ultimachine/Drude/Panels/ProjectOutputs/readme.txt

Readme File for Printed Circuit Board 'Drude_Panel_0-1a'

Board Specification
Part Number            DRUDE
Revision               01a
Board size             49.813mm x 73.00mm
Panel size             151.978mm x 85.90mm
Board Thickness        1.54mm (0.061")
Board type             Rigid
Number of layers       4
P.C.B material         FR4 / TG170
Finished Copper        1 oz
Finish                 ENIG (Gold) (Lead free) (RoHS)
Mask type              LPI 
Mask color             GREEN
Silk screen color      WHITE
Silk screen Sides      BOTH
Min trace width        4mil
Min clearance          4mil
Min Hole Diameter >=   8mil
Gold Edge Connectors   No
Internal slots/routes  
Blind Vias             No
Buried Vias            No
No of Boards/Panel     3
Routing                Routing + V-Score
Maximum Panel Size     250 X 280mm

Special Requirements
1. Fabricate PCB in accordiance with IPC-A-600 CLASS 2 (LATEST REVISION)
2. The PCB must be lead free assembly process compatible.
  Must handle minimum 6 cycles - 260C for 10 seconds.
3. Please ship PCB panelized as in gerber files.
  
UL LOGO + ID and ROHS logo to be placed on solder side (bottom silk screen) by board fab.

Critical Tolerances: 
1. GTL,GBL Differential Trace
	4mil, 8mil space  = 100ohm diff
	5mil, 8mil space = 90ohm diff
	Z = +/- 10%

Layer Description
(Note: Inner layers are counted from the top downwards)
Top Solder Mask               Drude_Panel_0.1a.GTS
Top Copper                    Drude_Panel_0.1a.GTL
Bottom Copper                 Drude_Panel_0.1a.GBL
Bottom Solder Mask            Drude_Panel_0.1a.GBS
Bottom Silk Screen            Drude_Panel_0.1a.GBO
Top Paste                     Drude_Panel_0.1a.GBP
NC Drill File                 Drude_Panel_0.1a.TXT
Outline			      		  Drude_Panel_0.1a.GM1
Fabrication Notes             Drude_Panel_0.1a.GM2
Panel Outline                 Drude_Panel_0.1a.GM30
V-Score                       Drude_Panel_0.1a.GM31
Panel Slots/Routing           Drude_Panel_0.1a.GM32

Contact Information
Address
Company        UltiMachine
Address        200 12th St. N.
City           South Pittsburg
State          TN
PostCode       37380
Country        USA
Email          info@ultimachine.com
Phone          423-228-0005

Purchasing contact : Lee Turner - lee@ultimachine.com
Technical contact  : Johnny Russell - johnny@ultimachine.com - 1-423-605-2598

Please quote quantities of:
21 pieces / 7 panels
102 pieces / 34 panels
504 pieces / 168 panels
