ultimachine/Drude/Drude/MessageListReport.html

Altium customize

# Message List

Date: | | 11/25/2015
Time: | | 12:50:40 PM
Elapsed Time: | | 00:00:00

Class | Document | Source | Message | Time | Date | No.
[Differential Pairs Routing Violation] | Drude02.PcbDoc | Advanced PCB | Differential Pairs Routing: Between Net HDMI_CK_P And Net HDMI_CK_N [Uncoupled Length = 106.7mil], [Maximum Uncoupled Length = 78.74mil] | 12:49:37 PM | 11/25/2015 | 1
[Differential Pairs Routing Violation] | Drude02.PcbDoc | Advanced PCB | Differential Pairs Routing: Between Net HDMI_D0_P And Net HDMI_D0_N [Uncoupled Length = 93.132mil], [Maximum Uncoupled Length = 78.74mil] | 12:49:37 PM | 11/25/2015 | 2
[Differential Pairs Routing Violation] | Drude02.PcbDoc | Advanced PCB | Differential Pairs Routing: Between Net HDMI_D1_P And Net HDMI_D1_N [Uncoupled Length = 82.128mil], [Maximum Uncoupled Length = 78.74mil] | 12:49:37 PM | 11/25/2015 | 3
[Differential Pairs Routing Violation] | Drude02.PcbDoc | Advanced PCB | Differential Pairs Routing: Between Net HDMI_D2_P And Net HDMI_D2_N [Uncoupled Length = 147.876mil], [Maximum Uncoupled Length = 78.74mil] | 12:49:37 PM | 11/25/2015 | 4
[Differential Pairs Routing Violation] | Drude02.PcbDoc | Advanced PCB | Differential Pairs Routing: Between Net HDMI_CON_CK_P And Net HDMI_CON_CK_N [Uncoupled Length = 102.772mil], [Maximum Uncoupled Length = 78.74mil] | 12:49:37 PM | 11/25/2015 | 5
[Differential Pairs Routing Violation] | Drude02.PcbDoc | Advanced PCB | Differential Pairs Routing: Between Net HDMI_CON_D0_P And Net HDMI_CON_D0_N [Uncoupled Length = 112.768mil], [Maximum Uncoupled Length = 78.74mil] | 12:49:37 PM | 11/25/2015 | 6
[Differential Pairs Routing Violation] | Drude02.PcbDoc | Advanced PCB | Differential Pairs Routing: Between Net HDMI_CON_D1_P And Net HDMI_CON_D1_N [Uncoupled Length = 112.823mil], [Maximum Uncoupled Length = 78.74mil] | 12:49:37 PM | 11/25/2015 | 7
[Differential Pairs Routing Violation] | Drude02.PcbDoc | Advanced PCB | Differential Pairs Routing: Between Net HDMI_CON_D2_P And Net HDMI_CON_D2_N [Uncoupled Length = 104.291mil], [Maximum Uncoupled Length = 78.74mil] | 12:49:37 PM | 11/25/2015 | 8
[Parallel Segment Constraint Violation] | Drude02.PcbDoc | Advanced PCB | Parallel Segment Constraint: (526.811mil > 500mil) Between Net UD_N And Net UD_P Gap < 42mil; Actual Parallel Span = 526.811mil | 12:49:37 PM | 11/25/2015 | 9
[Parallel Segment Constraint Violation] | Drude02.PcbDoc | Advanced PCB | Parallel Segment Constraint: (539.011mil > 500mil) Between Net LANE3_N And Net LANE3_P Gap < 42mil; Actual Parallel Span = 539.011mil | 12:49:37 PM | 11/25/2015 | 10
[Parallel Segment Constraint Violation] | Drude02.PcbDoc | Advanced PCB | Parallel Segment Constraint: (552.095mil > 500mil) Between Net LANE2_N And Net LANE2_P Gap < 42mil; Actual Parallel Span = 552.095mil | 12:49:37 PM | 11/25/2015 | 11
[Parallel Segment Constraint Violation] | Drude02.PcbDoc | Advanced PCB | Parallel Segment Constraint: (552.095mil > 500mil) Between Net LANE2_P And Net LANE2_N Gap < 42mil; Actual Parallel Span = 552.095mil | 12:49:37 PM | 11/25/2015 | 12
[Parallel Segment Constraint Violation] | Drude02.PcbDoc | Advanced PCB | Parallel Segment Constraint: (512.301mil > 500mil) Between Net LANE1_N And Net LANE1_P Gap < 42mil; Actual Parallel Span = 512.301mil | 12:49:37 PM | 11/25/2015 | 13
[Parallel Segment Constraint Violation] | Drude02.PcbDoc | Advanced PCB | Parallel Segment Constraint: (556.64mil > 500mil) Between Net LANE0_N And Net LANE0_P Gap < 42mil; Actual Parallel Span = 556.64mil | 12:49:37 PM | 11/25/2015 | 14
[Parallel Segment Constraint Violation] | Drude02.PcbDoc | Advanced PCB | Parallel Segment Constraint: (556.64mil > 500mil) Between Net LANE0_P And Net LANE0_N Gap < 42mil; Actual Parallel Span = 556.64mil | 12:49:37 PM | 11/25/2015 | 15
[Parallel Segment Constraint Violation] | Drude02.PcbDoc | Advanced PCB | Parallel Segment Constraint: (505.987mil > 500mil) Between Net DSI_CLK_N And Net DSI_CLK_P Gap < 42mil; Actual Parallel Span = 505.987mil | 12:49:37 PM | 11/25/2015 | 16
[Clearance Constraint Violation] | Drude02.PcbDoc | Advanced PCB | Clearance Constraint: (10mil < 12mil) Between Via (234mil,1432mil) from Top Layer to Bottom Layer And Via (224mil,1456mil) from Top Layer to Bottom Layer | 12:49:37 PM | 11/25/2015 | 17
[Short-Circuit Constraint Violation] | Drude02.PcbDoc | Advanced PCB | Short-Circuit Constraint: Between Pad H3-1(1577.945mil,98.197mil) on Top Layer And Arc (1637mil,173mil) on Top Layer Location : [X = 2967.945mil][Y = 598.197mil] | 12:49:37 PM | 11/25/2015 | 18
[Short-Circuit Constraint Violation] | Drude02.PcbDoc | Advanced PCB | Short-Circuit Constraint: Between Pad H1-1(1597.945mil,1887.197mil) on Top Layer And Arc (1657mil,1962mil) on Top Layer Location : [X = 2987.945mil][Y = 2387.197mil] | 12:49:37 PM | 11/25/2015 | 19
[Short-Circuit Constraint Violation] | Drude02.PcbDoc | Advanced PCB | Short-Circuit Constraint: Between Pad H2-1(124.945mil,2622.197mil) on Top Layer And Arc (184mil,2697mil) on Top Layer Location : [X = 1514.945mil][Y = 3122.197mil] | 12:49:37 PM | 11/25/2015 | 20
[Short-Circuit Constraint Violation] | Drude02.PcbDoc | Advanced PCB | Short-Circuit Constraint: Between Pad H4-1(102.945mil,91.197mil) on Top Layer And Arc (162mil,166mil) on Top Layer Location : [X = 1492.945mil][Y = 591.197mil] | 12:49:37 PM | 11/25/2015 | 21
[Acute Angle Constraint Violation] | Drude02.PcbDoc | Advanced PCB | Acute Angle Constraint: (56.051 < 60.000) Between Polygon Region (0 hole(s)) Top Layer And Region (0 hole(s)) Top Layer (Angle = 56.051) | 12:49:37 PM | 11/25/2015 | 22
[Acute Angle Constraint Violation] | Drude02.PcbDoc | Advanced PCB | Acute Angle Constraint: (48.943 < 60.000) Between Track (1517.337mil,2594.943mil)(1525.733mil,2595.315mil) on Top Layer And Pad D27-6(1525.733mil,2595.315mil) on Top Layer (Angle = 48.943) | 12:49:37 PM | 11/25/2015 | 23
[Acute Angle Constraint Violation] | Drude02.PcbDoc | Advanced PCB | Acute Angle Constraint: (50.384 < 60.000) Between Via (1002mil,2054mil) from Top Layer to Bottom Layer And Track (1014.314mil,2041.686mil)(1097.16mil,2041.686mil) on Bottom Layer (Angle = 50.384) | 12:49:37 PM | 11/25/2015 | 24
[Acute Angle Constraint Violation] | Drude02.PcbDoc | Advanced PCB | Acute Angle Constraint: (47.424 < 60.000) Between Pad C7-2(1080.709mil,771.851mil) on Top Layer And Track (1103.394mil,768.606mil)(1103.394mil,771.851mil) on Top Layer (Angle = 47.424) | 12:49:37 PM | 11/25/2015 | 25
[Acute Angle Constraint Violation] | Drude02.PcbDoc | Advanced PCB | Acute Angle Constraint: (58.135 < 60.000) Between Pad C56-1(826.3mil,2357mil) on Bottom Layer And Track (814.467mil,2369.833mil)(826.3mil,2358mil) on Bottom Layer (Angle = 58.135) | 12:49:37 PM | 11/25/2015 | 26
[Acute Angle Constraint Violation] | Drude02.PcbDoc | Advanced PCB | Acute Angle Constraint: (45.000 < 60.000) Between Pad C9-2(441.638mil,830.354mil) on Top Layer And Via (488.887mil,848.662mil) from Top Layer to Bottom Layer (Angle = 45.000) | 12:49:37 PM | 11/25/2015 | 27
[Acute Angle Constraint Violation] | Drude02.PcbDoc | Advanced PCB | Acute Angle Constraint: (54.868 < 60.000) Between Pad C11-2(356.394mil,549.457mil) on Top Layer And Via (370.772mil,596.701mil) from Top Layer to Bottom Layer (Angle = 54.868) | 12:49:37 PM | 11/25/2015 | 28
[Acute Angle Constraint Violation] | Drude02.PcbDoc | Advanced PCB | Acute Angle Constraint: (56.251 < 60.000) Between Via (879.386mil,2374.614mil) from Top Layer to Bottom Layer And Pad C56-2(864mil,2357mil) on Bottom Layer (Angle = 56.251) | 12:49:37 PM | 11/25/2015 | 29
[Acute Angle Constraint Violation] | Drude02.PcbDoc | Advanced PCB | Acute Angle Constraint: (45.000 < 60.000) Between Track (823.205mil,326.276mil)(836.767mil,312.713mil) on Top Layer And Track (787.398mil,312.713mil)(836.767mil,312.713mil) on Top Layer (Angle = 45.000) | 12:49:37 PM | 11/25/2015 | 30
[SMD To Corner Constraint Violation] | Drude02.PcbDoc | Advanced PCB | SMD To Corner Constraint: (0.169mil < 3mil) Between Pad U6-A4(711.386mil,1259.842mil) on Top Layer And Track (707.5mil,1255.957mil)(711.386mil,1259.842mil) on Top Layer Actual Distance = 0.169mil | 12:49:37 PM | 11/25/2015 | 31
[SMD To Corner Constraint Violation] | Drude02.PcbDoc | Advanced PCB | SMD To Corner Constraint: (1.733mil < 3mil) Between Pad U6-J2(762.567mil,1464.567mil) on Top Layer And Track (762.567mil,1464.567mil)(769.627mil,1464.567mil) on Top Layer Actual Distance = 1.733mil | 12:49:37 PM | 11/25/2015 | 32
[SMD To Corner Constraint Violation] | Drude02.PcbDoc | Advanced PCB | SMD To Corner Constraint: (0.236mil < 3mil) Between Pad U6-K9(583.433mil,1490.158mil) on Top Layer And Track (579.5mil,1494.091mil)(583.433mil,1490.158mil) on Top Layer Actual Distance = 0.236mil | 12:49:37 PM | 11/25/2015 | 33
[Minimum Solder Mask Sliver Constraint Violation] | Drude02.PcbDoc | Advanced PCB | Minimum Solder Mask Sliver Constraint: (3.843mil < 4mil) Between Pad U9-2(1098.874mil,2209.26mil) on Top Layer And Pad U9-1(1098.874mil,2189.575mil) on Top Layer [Top Solder] Mask Sliver [3.843mil] | 12:49:37 PM | 11/25/2015 | 34
[Minimum Solder Mask Sliver Constraint Violation] | Drude02.PcbDoc | Advanced PCB | Minimum Solder Mask Sliver Constraint: (3.843mil < 4mil) Between Pad U9-3(1098.874mil,2228.945mil) on Top Layer And Pad U9-2(1098.874mil,2209.26mil) on Top Layer [Top Solder] Mask Sliver [3.843mil] | 12:49:37 PM | 11/25/2015 | 35
[Minimum Solder Mask Sliver Constraint Violation] | Drude02.PcbDoc | Advanced PCB | Minimum Solder Mask Sliver Constraint: (3.843mil < 4mil) Between Pad U9-4(1098.874mil,2248.63mil) on Top Layer And Pad U9-3(1098.874mil,2228.945mil) on Top Layer [Top Solder] Mask Sliver [3.843mil] | 12:49:37 PM | 11/25/2015 | 36
[Minimum Solder Mask Sliver Constraint Violation] | Drude02.PcbDoc | Advanced PCB | Minimum Solder Mask Sliver Constraint: (3.843mil < 4mil) Between Pad U9-5(1098.874mil,2268.315mil) on Top Layer And Pad U9-4(1098.874mil,2248.63mil) on Top Layer [Top Solder] Mask Sliver [3.843mil] | 12:49:37 PM | 11/25/2015 | 37
[Minimum Solder Mask Sliver Constraint Violation] | Drude02.PcbDoc | Advanced PCB | Minimum Solder Mask Sliver Constraint: (3.843mil < 4mil) Between Pad U9-6(1098.874mil,2288mil) on Top Layer And Pad U9-5(1098.874mil,2268.315mil) on Top Layer [Top Solder] Mask Sliver [3.843mil] | 12:49:37 PM | 11/25/2015 | 38
[Minimum Solder Mask Sliver Constraint Violation] | Drude02.PcbDoc | Advanced PCB | Minimum Solder Mask Sliver Constraint: (3.843mil < 4mil) Between Pad U9-6(1098.874mil,2288mil) on Top Layer And Pad U9-7(1098.874mil,2307.685mil) on Top Layer [Top Solder] Mask Sliver [3.843mil] | 12:49:37 PM | 11/25/2015 | 39
[Minimum Solder Mask Sliver Constraint Violation] | Drude02.PcbDoc | Advanced PCB | Minimum Solder Mask Sliver Constraint: (3.843mil < 4mil) Between Pad U9-8(1098.874mil,2327.37mil) on Top Layer And Pad U9-7(1098.874mil,2307.685mil) on Top Layer [Top Solder] Mask Sliver [3.843mil] | 12:49:37 PM | 11/25/2015 | 40
[Minimum Solder Mask Sliver Constraint Violation] | Drude02.PcbDoc | Advanced PCB | Minimum Solder Mask Sliver Constraint: (3.843mil < 4mil) Between Pad U9-9(1098.874mil,2347.055mil) on Top Layer And Pad U9-8(1098.874mil,2327.37mil) on Top Layer [Top Solder] Mask Sliver [3.843mil] | 12:49:37 PM | 11/25/2015 | 41
[Minimum Solder Mask Sliver Constraint Violation] | Drude02.PcbDoc | Advanced PCB | Minimum Solder Mask Sliver Constraint: (3.843mil < 4mil) Between Pad U9-10(1098.874mil,2366.74mil) on Top Layer And Pad U9-9(1098.874mil,2347.055mil) on Top Layer [Top Solder] Mask Sliver [3.843mil] | 12:49:37 PM | 11/25/2015 | 42
[Minimum Solder Mask Sliver Constraint Violation] | Drude02.PcbDoc | Advanced PCB | Minimum Solder Mask Sliver Constraint: (3.843mil < 4mil) Between Pad U9-10(1098.874mil,2366.74mil) on Top Layer And Pad U9-11(1098.874mil,2386.425mil) on Top Layer [Top Solder] Mask Sliver [3.843mil] | 12:49:37 PM | 11/25/2015 | 43
[Minimum Solder Mask Sliver Constraint Violation] | Drude02.PcbDoc | Advanced PCB | Minimum Solder Mask Sliver Constraint: (3.843mil < 4mil) Between Pad U9-13(1044.74mil,2420.874mil) on Top Layer And Pad U9-12(1064.425mil,2420.874mil) on Top Layer [Top Solder] Mask Sliver [3.843mil] | 12:49:37 PM | 11/25/2015 | 44
[Minimum Solder Mask Sliver Constraint Violation] | Drude02.PcbDoc | Advanced PCB | Minimum Solder Mask Sliver Constraint: (3.843mil < 4mil) Between Pad U9-14(1025.055mil,2420.874mil) on Top Layer And Pad U9-13(1044.74mil,2420.874mil) on Top Layer [Top Solder] Mask Sliver [3.843mil] | 12:49:37 PM | 11/25/2015 | 45
[Minimum Solder Mask Sliver Constraint Violation] | Drude02.PcbDoc | Advanced PCB | Minimum Solder Mask Sliver Constraint: (3.843mil < 4mil) Between Pad U9-15(1005.37mil,2420.874mil) on Top Layer And Pad U9-14(1025.055mil,2420.874mil) on Top Layer [Top Solder] Mask Sliver [3.843mil] | 12:49:37 PM | 11/25/2015 | 46
[Minimum Solder Mask Sliver Constraint Violation] | Drude02.PcbDoc | Advanced PCB | Minimum Solder Mask Sliver Constraint: (3.843mil < 4mil) Between Pad U9-16(985.685mil,2420.874mil) on Top Layer And Pad U9-15(1005.37mil,2420.874mil) on Top Layer [Top Solder] Mask Sliver [3.843mil] | 12:49:37 PM | 11/25/2015 | 47
[Minimum Solder Mask Sliver Constraint Violation] | Drude02.PcbDoc | Advanced PCB | Minimum Solder Mask Sliver Constraint: (3.843mil < 4mil) Between Pad U9-17(966mil,2420.874mil) on Top Layer And Pad U9-16(985.685mil,2420.874mil) on Top Layer [Top Solder] Mask Sliver [3.843mil] | 12:49:37 PM | 11/25/2015 | 48
[Minimum Solder Mask Sliver Constraint Violation] | Drude02.PcbDoc | Advanced PCB | Minimum Solder Mask Sliver Constraint: (3.843mil < 4mil) Between Pad U9-18(946.315mil,2420.874mil) on Top Layer And Pad U9-17(966mil,2420.874mil) on Top Layer [Top Solder] Mask Sliver [3.843mil] | 12:49:37 PM | 11/25/2015 | 49
[Minimum Solder Mask Sliver Constraint Violation] | Drude02.PcbDoc | Advanced PCB | Minimum Solder Mask Sliver Constraint: (3.843mil < 4mil) Between Pad U9-19(926.63mil,2420.874mil) on Top Layer And Pad U9-18(946.315mil,2420.874mil) on Top Layer [Top Solder] Mask Sliver [3.843mil] | 12:49:37 PM | 11/25/2015 | 50
[Minimum Solder Mask Sliver Constraint Violation] | Drude02.PcbDoc | Advanced PCB | Minimum Solder Mask Sliver Constraint: (3.843mil < 4mil) Between Pad U9-20(906.945mil,2420.874mil) on Top Layer And Pad U9-19(926.63mil,2420.874mil) on Top Layer [Top Solder] Mask Sliver [3.843mil] | 12:49:37 PM | 11/25/2015 | 51
[Minimum Solder Mask Sliver Constraint Violation] | Drude02.PcbDoc | Advanced PCB | Minimum Solder Mask Sliver Constraint: (3.843mil < 4mil) Between Pad U9-21(887.26mil,2420.874mil) on Top Layer And Pad U9-20(906.945mil,2420.874mil) on Top Layer [Top Solder] Mask Sliver [3.843mil] | 12:49:37 PM | 11/25/2015 | 52
[Minimum Solder Mask Sliver Constraint Violation] | Drude02.PcbDoc | Advanced PCB | Minimum Solder Mask Sliver Constraint: (3.843mil < 4mil) Between Pad U9-22(867.575mil,2420.874mil) on Top Layer And Pad U9-21(887.26mil,2420.874mil) on Top Layer [Top Solder] Mask Sliver [3.843mil] | 12:49:37 PM | 11/25/2015 | 53
[Minimum Solder Mask Sliver Constraint Violation] | Drude02.PcbDoc | Advanced PCB | Minimum Solder Mask Sliver Constraint: (3.843mil < 4mil) Between Pad U9-24(833.126mil,2366.74mil) on Top Layer And Pad U9-23(833.126mil,2386.425mil) on Top Layer [Top Solder] Mask Sliver [3.843mil] | 12:49:37 PM | 11/25/2015 | 54
[Minimum Solder Mask Sliver Constraint Violation] | Drude02.PcbDoc | Advanced PCB | Minimum Solder Mask Sliver Constraint: (3.843mil < 4mil) Between Pad U9-25(833.126mil,2347.055mil) on Top Layer And Pad U9-24(833.126mil,2366.74mil) on Top Layer [Top Solder] Mask Sliver [3.843mil] | 12:49:37 PM | 11/25/2015 | 55
[Minimum Solder Mask Sliver Constraint Violation] | Drude02.PcbDoc | Advanced PCB | Minimum Solder Mask Sliver Constraint: (3.843mil < 4mil) Between Pad U9-26(833.126mil,2327.37mil) on Top Layer And Pad U9-25(833.126mil,2347.055mil) on Top Layer [Top Solder] Mask Sliver [3.843mil] | 12:49:37 PM | 11/25/2015 | 56
[Minimum Solder Mask Sliver Constraint Violation] | Drude02.PcbDoc | Advanced PCB | Minimum Solder Mask Sliver Constraint: (3.843mil < 4mil) Between Pad U9-27(833.126mil,2307.685mil) on Top Layer And Pad U9-26(833.126mil,2327.37mil) on Top Layer [Top Solder] Mask Sliver [3.843mil] | 12:49:37 PM | 11/25/2015 | 57
[Minimum Solder Mask Sliver Constraint Violation] | Drude02.PcbDoc | Advanced PCB | Minimum Solder Mask Sliver Constraint: (3.843mil < 4mil) Between Pad U9-28(833.126mil,2288mil) on Top Layer And Pad U9-27(833.126mil,2307.685mil) on Top Layer [Top Solder] Mask Sliver [3.843mil] | 12:49:37 PM | 11/25/2015 | 58
[Minimum Solder Mask Sliver Constraint Violation] | Drude02.PcbDoc | Advanced PCB | Minimum Solder Mask Sliver Constraint: (3.843mil < 4mil) Between Pad U9-29(833.126mil,2268.315mil) on Top Layer And Pad U9-28(833.126mil,2288mil) on Top Layer [Top Solder] Mask Sliver [3.843mil] | 12:49:37 PM | 11/25/2015 | 59
[Minimum Solder Mask Sliver Constraint Violation] | Drude02.PcbDoc | Advanced PCB | Minimum Solder Mask Sliver Constraint: (3.843mil < 4mil) Between Pad U9-30(833.126mil,2248.63mil) on Top Layer And Pad U9-29(833.126mil,2268.315mil) on Top Layer [Top Solder] Mask Sliver [3.843mil] | 12:49:37 PM | 11/25/2015 | 60
[Minimum Solder Mask Sliver Constraint Violation] | Drude02.PcbDoc | Advanced PCB | Minimum Solder Mask Sliver Constraint: (3.843mil < 4mil) Between Pad U9-31(833.126mil,2228.945mil) on Top Layer And Pad U9-30(833.126mil,2248.63mil) on Top Layer [Top Solder] Mask Sliver [3.843mil] | 12:49:37 PM | 11/25/2015 | 61
[Minimum Solder Mask Sliver Constraint Violation] | Drude02.PcbDoc | Advanced PCB | Minimum Solder Mask Sliver Constraint: (3.843mil < 4mil) Between Pad U9-32(833.126mil,2209.26mil) on Top Layer And Pad U9-31(833.126mil,2228.945mil) on Top Layer [Top Solder] Mask Sliver [3.843mil] | 12:49:37 PM | 11/25/2015 | 62
[Minimum Solder Mask Sliver Constraint Violation] | Drude02.PcbDoc | Advanced PCB | Minimum Solder Mask Sliver Constraint: (3.843mil < 4mil) Between Pad U9-33(833.126mil,2189.575mil) on Top Layer And Pad U9-32(833.126mil,2209.26mil) on Top Layer [Top Solder] Mask Sliver [3.843mil] | 12:49:37 PM | 11/25/2015 | 63
[Minimum Solder Mask Sliver Constraint Violation] | Drude02.PcbDoc | Advanced PCB | Minimum Solder Mask Sliver Constraint: (3.843mil < 4mil) Between Pad U9-35(887.26mil,2155.126mil) on Top Layer And Pad U9-34(867.575mil,2155.126mil) on Top Layer [Top Solder] Mask Sliver [3.843mil] | 12:49:37 PM | 11/25/2015 | 64
[Minimum Solder Mask Sliver Constraint Violation] | Drude02.PcbDoc | Advanced PCB | Minimum Solder Mask Sliver Constraint: (3.843mil < 4mil) Between Pad U9-36(906.945mil,2155.126mil) on Top Layer And Pad U9-35(887.26mil,2155.126mil) on Top Layer [Top Solder] Mask Sliver [3.843mil] | 12:49:37 PM | 11/25/2015 | 65
[Minimum Solder Mask Sliver Constraint Violation] | Drude02.PcbDoc | Advanced PCB | Minimum Solder Mask Sliver Constraint: (3.843mil < 4mil) Between Pad U9-37(926.63mil,2155.126mil) on Top Layer And Pad U9-36(906.945mil,2155.126mil) on Top Layer [Top Solder] Mask Sliver [3.843mil] | 12:49:37 PM | 11/25/2015 | 66
[Minimum Solder Mask Sliver Constraint Violation] | Drude02.PcbDoc | Advanced PCB | Minimum Solder Mask Sliver Constraint: (3.843mil < 4mil) Between Pad U9-38(946.315mil,2155.126mil) on Top Layer And Pad U9-37(926.63mil,2155.126mil) on Top Layer [Top Solder] Mask Sliver [3.843mil] | 12:49:37 PM | 11/25/2015 | 67
[Minimum Solder Mask Sliver Constraint Violation] | Drude02.PcbDoc | Advanced PCB | Minimum Solder Mask Sliver Constraint: (3.843mil < 4mil) Between Pad U9-39(966mil,2155.126mil) on Top Layer And Pad U9-38(946.315mil,2155.126mil) on Top Layer [Top Solder] Mask Sliver [3.843mil] | 12:49:37 PM | 11/25/2015 | 68
[Minimum Solder Mask Sliver Constraint Violation] | Drude02.PcbDoc | Advanced PCB | Minimum Solder Mask Sliver Constraint: (3.843mil < 4mil) Between Pad U9-40(985.685mil,2155.126mil) on Top Layer And Pad U9-39(966mil,2155.126mil) on Top Layer [Top Solder] Mask Sliver [3.843mil] | 12:49:37 PM | 11/25/2015 | 69
[Minimum Solder Mask Sliver Constraint Violation] | Drude02.PcbDoc | Advanced PCB | Minimum Solder Mask Sliver Constraint: (3.843mil < 4mil) Between Pad U9-41(1005.37mil,2155.126mil) on Top Layer And Pad U9-40(985.685mil,2155.126mil) on Top Layer [Top Solder] Mask Sliver [3.843mil] | 12:49:37 PM | 11/25/2015 | 70
[Minimum Solder Mask Sliver Constraint Violation] | Drude02.PcbDoc | Advanced PCB | Minimum Solder Mask Sliver Constraint: (3.843mil < 4mil) Between Pad U9-42(1025.055mil,2155.126mil) on Top Layer And Pad U9-41(1005.37mil,2155.126mil) on Top Layer [Top Solder] Mask Sliver [3.843mil] | 12:49:37 PM | 11/25/2015 | 71
[Minimum Solder Mask Sliver Constraint Violation] | Drude02.PcbDoc | Advanced PCB | Minimum Solder Mask Sliver Constraint: (3.843mil < 4mil) Between Pad U9-43(1044.74mil,2155.126mil) on Top Layer And Pad U9-42(1025.055mil,2155.126mil) on Top Layer [Top Solder] Mask Sliver [3.843mil] | 12:49:37 PM | 11/25/2015 | 72
[Minimum Solder Mask Sliver Constraint Violation] | Drude02.PcbDoc | Advanced PCB | Minimum Solder Mask Sliver Constraint: (3.843mil < 4mil) Between Pad U9-44(1064.425mil,2155.126mil) on Top Layer And Pad U9-43(1044.74mil,2155.126mil) on Top Layer [Top Solder] Mask Sliver [3.843mil] | 12:49:37 PM | 11/25/2015 | 73
[Minimum Solder Mask Sliver Constraint Violation] | Drude02.PcbDoc | Advanced PCB | Minimum Solder Mask Sliver Constraint: (1.874mil < 4mil) Between Pad J1-4(1477.748mil,1400.953mil) on Top Layer And Pad J1-3(1477.748mil,1420.638mil) on Top Layer [Top Solder] Mask Sliver [1.874mil] | 12:49:37 PM | 11/25/2015 | 74
[Minimum Solder Mask Sliver Constraint Violation] | Drude02.PcbDoc | Advanced PCB | Minimum Solder Mask Sliver Constraint: (1.874mil < 4mil) Between Pad J1-2(1477.748mil,1440.323mil) on Top Layer And Pad J1-3(1477.748mil,1420.638mil) on Top Layer [Top Solder] Mask Sliver [1.874mil] | 12:49:37 PM | 11/25/2015 | 75
[Minimum Solder Mask Sliver Constraint Violation] | Drude02.PcbDoc | Advanced PCB | Minimum Solder Mask Sliver Constraint: (1.874mil < 4mil) Between Pad J1-2(1477.748mil,1440.323mil) on Top Layer And Pad J1-1(1477.748mil,1460.008mil) on Top Layer [Top Solder] Mask Sliver [1.874mil] | 12:49:37 PM | 11/25/2015 | 76
[Minimum Solder Mask Sliver Constraint Violation] | Drude02.PcbDoc | Advanced PCB | Minimum Solder Mask Sliver Constraint: (3.843mil < 4mil) Between Pad U2-7(1140.748mil,737.205mil) on Top Layer And Pad U2-6(1140.748mil,756.89mil) on Top Layer [Top Solder] Mask Sliver [3.843mil] | 12:49:37 PM | 11/25/2015 | 77
[Minimum Solder Mask Sliver Constraint Violation] | Drude02.PcbDoc | Advanced PCB | Minimum Solder Mask Sliver Constraint: (3.843mil < 4mil) Between Pad U2-8(1140.748mil,717.52mil) on Top Layer And Pad U2-7(1140.748mil,737.205mil) on Top Layer [Top Solder] Mask Sliver [3.843mil] | 12:49:37 PM | 11/25/2015 | 78
[Minimum Solder Mask Sliver Constraint Violation] | Drude02.PcbDoc | Advanced PCB | Minimum Solder Mask Sliver Constraint: (3.843mil < 4mil) Between Pad U2-9(1140.748mil,697.835mil) on Top Layer And Pad U2-8(1140.748mil,717.52mil) on Top Layer [Top Solder] Mask Sliver [3.843mil] | 12:49:37 PM | 11/25/2015 | 79
[Minimum Solder Mask Sliver Constraint Violation] | Drude02.PcbDoc | Advanced PCB | Minimum Solder Mask Sliver Constraint: (3.843mil < 4mil) Between Pad U2-10(1140.748mil,678.15mil) on Top Layer And Pad U2-9(1140.748mil,697.835mil) on Top Layer [Top Solder] Mask Sliver [3.843mil] | 12:49:37 PM | 11/25/2015 | 80
[Minimum Solder Mask Sliver Constraint Violation] | Drude02.PcbDoc | Advanced PCB | Minimum Solder Mask Sliver Constraint: (3.843mil < 4mil) Between Pad U2-4(1312.008mil,737.205mil) on Top Layer And Pad U2-5(1312.008mil,756.89mil) on Top Layer [Top Solder] Mask Sliver [3.843mil] | 12:49:37 PM | 11/25/2015 | 81
[Minimum Solder Mask Sliver Constraint Violation] | Drude02.PcbDoc | Advanced PCB | Minimum Solder Mask Sliver Constraint: (3.843mil < 4mil) Between Pad U2-3(1312.008mil,717.52mil) on Top Layer And Pad U2-4(1312.008mil,737.205mil) on Top Layer [Top Solder] Mask Sliver [3.843mil] | 12:49:37 PM | 11/25/2015 | 82
[Minimum Solder Mask Sliver Constraint Violation] | Drude02.PcbDoc | Advanced PCB | Minimum Solder Mask Sliver Constraint: (3.843mil < 4mil) Between Pad U2-2(1312.008mil,697.835mil) on Top Layer And Pad U2-3(1312.008mil,717.52mil) on Top Layer [Top Solder] Mask Sliver [3.843mil] | 12:49:37 PM | 11/25/2015 | 83
[Minimum Solder Mask Sliver Constraint Violation] | Drude02.PcbDoc | Advanced PCB | Minimum Solder Mask Sliver Constraint: (3.843mil < 4mil) Between Pad U2-1(1312.008mil,678.15mil) on Top Layer And Pad U2-2(1312.008mil,697.835mil) on Top Layer [Top Solder] Mask Sliver [3.843mil] | 12:49:37 PM | 11/25/2015 | 84
[Minimum Solder Mask Sliver Constraint Violation] | Drude02.PcbDoc | Advanced PCB | Minimum Solder Mask Sliver Constraint: (3.843mil < 4mil) Between Pad U1-7(855.512mil,713.504mil) on Top Layer And Pad U1-6(875.197mil,713.504mil) on Top Layer [Top Solder] Mask Sliver [3.843mil] | 12:49:37 PM | 11/25/2015 | 85
[Minimum Solder Mask Sliver Constraint Violation] | Drude02.PcbDoc | Advanced PCB | Minimum Solder Mask Sliver Constraint: (3.843mil < 4mil) Between Pad U1-8(835.827mil,713.504mil) on Top Layer And Pad U1-7(855.512mil,713.504mil) on Top Layer [Top Solder] Mask Sliver [3.843mil] | 12:49:37 PM | 11/25/2015 | 86
[Minimum Solder Mask Sliver Constraint Violation] | Drude02.PcbDoc | Advanced PCB | Minimum Solder Mask Sliver Constraint: (3.843mil < 4mil) Between Pad U1-9(816.142mil,713.504mil) on Top Layer And Pad U1-8(835.827mil,713.504mil) on Top Layer [Top Solder] Mask Sliver [3.843mil] | 12:49:37 PM | 11/25/2015 | 87
[Minimum Solder Mask Sliver Constraint Violation] | Drude02.PcbDoc | Advanced PCB | Minimum Solder Mask Sliver Constraint: (3.843mil < 4mil) Between Pad U1-10(796.457mil,713.504mil) on Top Layer And Pad U1-9(816.142mil,713.504mil) on Top Layer [Top Solder] Mask Sliver [3.843mil] | 12:49:37 PM | 11/25/2015 | 88
[Minimum Solder Mask Sliver Constraint Violation] | Drude02.PcbDoc | Advanced PCB | Minimum Solder Mask Sliver Constraint: (3.843mil < 4mil) Between Pad U1-4(855.512mil,542.244mil) on Top Layer And Pad U1-5(875.197mil,542.244mil) on Top Layer [Top Solder] Mask Sliver [3.843mil] | 12:49:37 PM | 11/25/2015 | 89
[Minimum Solder Mask Sliver Constraint Violation] | Drude02.PcbDoc | Advanced PCB | Minimum Solder Mask Sliver Constraint: (3.843mil < 4mil) Between Pad U1-3(835.827mil,542.244mil) on Top Layer And Pad U1-4(855.512mil,542.244mil) on Top Layer [Top Solder] Mask Sliver [3.843mil] | 12:49:37 PM | 11/25/2015 | 90
[Minimum Solder Mask Sliver Constraint Violation] | Drude02.PcbDoc | Advanced PCB | Minimum Solder Mask Sliver Constraint: (3.843mil < 4mil) Between Pad U1-2(816.142mil,542.244mil) on Top Layer And Pad U1-3(835.827mil,542.244mil) on Top Layer [Top Solder] Mask Sliver [3.843mil] | 12:49:37 PM | 11/25/2015 | 91
[Minimum Solder Mask Sliver Constraint Violation] | Drude02.PcbDoc | Advanced PCB | Minimum Solder Mask Sliver Constraint: (3.843mil < 4mil) Between Pad U1-1(796.457mil,542.244mil) on Top Layer And Pad U1-2(816.142mil,542.244mil) on Top Layer [Top Solder] Mask Sliver [3.843mil] | 12:49:37 PM | 11/25/2015 | 92
[Minimum Solder Mask Sliver Constraint Violation] | Drude02.PcbDoc | Advanced PCB | Minimum Solder Mask Sliver Constraint: (3.055mil < 4mil) Between Pad D27-2(1552.288mil,2615mil) on Top Layer And Pad D27-1(1552.288mil,2595.315mil) on Top Layer [Top Solder] Mask Sliver [3.055mil] | 12:49:37 PM | 11/25/2015 | 93
[Minimum Solder Mask Sliver Constraint Violation] | Drude02.PcbDoc | Advanced PCB | Minimum Solder Mask Sliver Constraint: (3.055mil < 4mil) Between Pad D27-5(1525.733mil,2615mil) on Top Layer And Pad D27-6(1525.733mil,2595.315mil) on Top Layer [Top Solder] Mask Sliver [3.055mil] | 12:49:37 PM | 11/25/2015 | 94
[Minimum Solder Mask Sliver Constraint Violation] | Drude02.PcbDoc | Advanced PCB | Minimum Solder Mask Sliver Constraint: (3.055mil < 4mil) Between Pad D27-3(1552.288mil,2634.685mil) on Top Layer And Pad D27-2(1552.288mil,2615mil) on Top Layer [Top Solder] Mask Sliver [3.055mil] | 12:49:37 PM | 11/25/2015 | 95
[Minimum Solder Mask Sliver Constraint Violation] | Drude02.PcbDoc | Advanced PCB | Minimum Solder Mask Sliver Constraint: (3.055mil < 4mil) Between Pad D27-4(1525.733mil,2634.685mil) on Top Layer And Pad D27-5(1525.733mil,2615mil) on Top Layer [Top Solder] Mask Sliver [3.055mil] | 12:49:37 PM | 11/25/2015 | 96
[Minimum Solder Mask Sliver Constraint Violation] | Drude02.PcbDoc | Advanced PCB | Minimum Solder Mask Sliver Constraint: (3.842mil < 4mil) Between Pad J2-4(1648.701mil,2654.591mil) on Top Layer And Pad J2-5(1648.701mil,2680.181mil) on Top Layer [Top Solder] Mask Sliver [3.842mil] | 12:49:37 PM | 11/25/2015 | 97
[Minimum Solder Mask Sliver Constraint Violation] | Drude02.PcbDoc | Advanced PCB | Minimum Solder Mask Sliver Constraint: (3.843mil < 4mil) Between Pad J2-3(1648.701mil,2629mil) on Top Layer And Pad J2-4(1648.701mil,2654.591mil) on Top Layer [Top Solder] Mask Sliver [3.843mil] | 12:49:37 PM | 11/25/2015 | 98
[Minimum Solder Mask Sliver Constraint Violation] | Drude02.PcbDoc | Advanced PCB | Minimum Solder Mask Sliver Constraint: (3.843mil < 4mil) Between Pad J2-2(1648.701mil,2603.409mil) on Top Layer And Pad J2-3(1648.701mil,2629mil) on Top Layer [Top Solder] Mask Sliver [3.843mil] | 12:49:37 PM | 11/25/2015 | 99
[Minimum Solder Mask Sliver Constraint Violation] | Drude02.PcbDoc | Advanced PCB | Minimum Solder Mask Sliver Constraint: (3.842mil < 4mil) Between Pad J2-1(1648.701mil,2577.819mil) on Top Layer And Pad J2-2(1648.701mil,2603.409mil) on Top Layer [Top Solder] Mask Sliver [3.842mil] | 12:49:37 PM | 11/25/2015 | 100
[Minimum Solder Mask Sliver Constraint Violation] | Drude02.PcbDoc | Advanced PCB | Minimum Solder Mask Sliver Constraint: (1.874mil < 4mil) Between Pad J1-5(1477.748mil,1381.268mil) on Top Layer And Pad J1-4(1477.748mil,1400.953mil) on Top Layer [Top Solder] Mask Sliver [1.874mil] | 12:49:37 PM | 11/25/2015 | 101
[Minimum Solder Mask Sliver Constraint Violation] | Drude02.PcbDoc | Advanced PCB | Minimum Solder Mask Sliver Constraint: (1.874mil < 4mil) Between Pad J1-6(1477.748mil,1361.583mil) on Top Layer And Pad J1-5(1477.748mil,1381.268mil) on Top Layer [Top Solder] Mask Sliver [1.874mil] | 12:49:37 PM | 11/25/2015 | 102
[Minimum Solder Mask Sliver Constraint Violation] | Drude02.PcbDoc | Advanced PCB | Minimum Solder Mask Sliver Constraint: (1.874mil < 4mil) Between Pad J1-7(1477.748mil,1341.898mil) on Top Layer And Pad J1-6(1477.748mil,1361.583mil) on Top Layer [Top Solder] Mask Sliver [1.874mil] | 12:49:37 PM | 11/25/2015 | 103
[Minimum Solder Mask Sliver Constraint Violation] | Drude02.PcbDoc | Advanced PCB | Minimum Solder Mask Sliver Constraint: (1.874mil < 4mil) Between Pad J1-8(1477.748mil,1322.213mil) on Top Layer And Pad J1-7(1477.748mil,1341.898mil) on Top Layer [Top Solder] Mask Sliver [1.874mil] | 12:49:37 PM | 11/25/2015 | 104
[Minimum Solder Mask Sliver Constraint Violation] | Drude02.PcbDoc | Advanced PCB | Minimum Solder Mask Sliver Constraint: (1.874mil < 4mil) Between Pad J1-9(1477.748mil,1302.528mil) on Top Layer And Pad J1-8(1477.748mil,1322.213mil) on Top Layer [Top Solder] Mask Sliver [1.874mil] | 12:49:37 PM | 11/25/2015 | 105
[Minimum Solder Mask Sliver Constraint Violation] | Drude02.PcbDoc | Advanced PCB | Minimum Solder Mask Sliver Constraint: (1.874mil < 4mil) Between Pad J1-10(1477.748mil,1282.842mil) on Top Layer And Pad J1-9(1477.748mil,1302.528mil) on Top Layer [Top Solder] Mask Sliver [1.874mil] | 12:49:37 PM | 11/25/2015 | 106
[Minimum Solder Mask Sliver Constraint Violation] | Drude02.PcbDoc | Advanced PCB | Minimum Solder Mask Sliver Constraint: (1.874mil < 4mil) Between Pad J1-11(1477.748mil,1263.158mil) on Top Layer And Pad J1-10(1477.748mil,1282.842mil) on Top Layer [Top Solder] Mask Sliver [1.874mil] | 12:49:37 PM | 11/25/2015 | 107
[Minimum Solder Mask Sliver Constraint Violation] | Drude02.PcbDoc | Advanced PCB | Minimum Solder Mask Sliver Constraint: (1.874mil < 4mil) Between Pad J1-12(1477.748mil,1243.473mil) on Top Layer And Pad J1-11(1477.748mil,1263.158mil) on Top Layer [Top Solder] Mask Sliver [1.874mil] | 12:49:37 PM | 11/25/2015 | 108
[Minimum Solder Mask Sliver Constraint Violation] | Drude02.PcbDoc | Advanced PCB | Minimum Solder Mask Sliver Constraint: (1.874mil < 4mil) Between Pad J1-13(1477.748mil,1223.787mil) on Top Layer And Pad J1-12(1477.748mil,1243.473mil) on Top Layer [Top Solder] Mask Sliver [1.874mil] | 12:49:37 PM | 11/25/2015 | 109
[Minimum Solder Mask Sliver Constraint Violation] | Drude02.PcbDoc | Advanced PCB | Minimum Solder Mask Sliver Constraint: (1.874mil < 4mil) Between Pad J1-14(1477.748mil,1204.102mil) on Top Layer And Pad J1-13(1477.748mil,1223.787mil) on Top Layer [Top Solder] Mask Sliver [1.874mil] | 12:49:37 PM | 11/25/2015 | 110
[Minimum Solder Mask Sliver Constraint Violation] | Drude02.PcbDoc | Advanced PCB | Minimum Solder Mask Sliver Constraint: (1.874mil < 4mil) Between Pad J1-15(1477.748mil,1184.417mil) on Top Layer And Pad J1-14(1477.748mil,1204.102mil) on Top Layer [Top Solder] Mask Sliver [1.874mil] | 12:49:37 PM | 11/25/2015 | 111
[Minimum Solder Mask Sliver Constraint Violation] | Drude02.PcbDoc | Advanced PCB | Minimum Solder Mask Sliver Constraint: (1.874mil < 4mil) Between Pad J1-16(1477.748mil,1164.732mil) on Top Layer And Pad J1-15(1477.748mil,1184.417mil) on Top Layer [Top Solder] Mask Sliver [1.874mil] | 12:49:37 PM | 11/25/2015 | 112
[Minimum Solder Mask Sliver Constraint Violation] | Drude02.PcbDoc | Advanced PCB | Minimum Solder Mask Sliver Constraint: (1.874mil < 4mil) Between Pad J1-17(1477.748mil,1145.047mil) on Top Layer And Pad J1-16(1477.748mil,1164.732mil) on Top Layer [Top Solder] Mask Sliver [1.874mil] | 12:49:37 PM | 11/25/2015 | 113
[Minimum Solder Mask Sliver Constraint Violation] | Drude02.PcbDoc | Advanced PCB | Minimum Solder Mask Sliver Constraint: (1.874mil < 4mil) Between Pad J1-18(1477.748mil,1125.362mil) on Top Layer And Pad J1-17(1477.748mil,1145.047mil) on Top Layer [Top Solder] Mask Sliver [1.874mil] | 12:49:37 PM | 11/25/2015 | 114
[Minimum Solder Mask Sliver Constraint Violation] | Drude02.PcbDoc | Advanced PCB | Minimum Solder Mask Sliver Constraint: (1.874mil < 4mil) Between Pad J1-19(1477.748mil,1105.677mil) on Top Layer And Pad J1-18(1477.748mil,1125.362mil) on Top Layer [Top Solder] Mask Sliver [1.874mil] | 12:49:37 PM | 11/25/2015 | 115
[Minimum Solder Mask Sliver Constraint Violation] | Drude02.PcbDoc | Advanced PCB | Minimum Solder Mask Sliver Constraint: (1.874mil < 4mil) Between Pad U11-7(1403.543mil,2583.071mil) on Bottom Layer And Pad U11-8(1403.543mil,2563.386mil) on Bottom Layer [Bottom Solder] Mask Sliver [1.874mil] | 12:49:37 PM | 11/25/2015 | 116
[Minimum Solder Mask Sliver Constraint Violation] | Drude02.PcbDoc | Advanced PCB | Minimum Solder Mask Sliver Constraint: (1.874mil < 4mil) Between Pad U11-6(1403.543mil,2602.756mil) on Bottom Layer And Pad U11-7(1403.543mil,2583.071mil) on Bottom Layer [Bottom Solder] Mask Sliver [1.874mil] | 12:49:37 PM | 11/25/2015 | 117
[Minimum Solder Mask Sliver Constraint Violation] | Drude02.PcbDoc | Advanced PCB | Minimum Solder Mask Sliver Constraint: (1.874mil < 4mil) Between Pad U11-5(1403.543mil,2622.441mil) on Bottom Layer And Pad U11-6(1403.543mil,2602.756mil) on Bottom Layer [Bottom Solder] Mask Sliver [1.874mil] | 12:49:37 PM | 11/25/2015 | 118
[Minimum Solder Mask Sliver Constraint Violation] | Drude02.PcbDoc | Advanced PCB | Minimum Solder Mask Sliver Constraint: (1.874mil < 4mil) Between Pad U11-4(1403.543mil,2642.126mil) on Bottom Layer And Pad U11-5(1403.543mil,2622.441mil) on Bottom Layer [Bottom Solder] Mask Sliver [1.874mil] | 12:49:37 PM | 11/25/2015 | 119
[Minimum Solder Mask Sliver Constraint Violation] | Drude02.PcbDoc | Advanced PCB | Minimum Solder Mask Sliver Constraint: (1.874mil < 4mil) Between Pad U11-3(1403.543mil,2661.811mil) on Bottom Layer And Pad U11-4(1403.543mil,2642.126mil) on Bottom Layer [Bottom Solder] Mask Sliver [1.874mil] | 12:49:37 PM | 11/25/2015 | 120
[Minimum Solder Mask Sliver Constraint Violation] | Drude02.PcbDoc | Advanced PCB | Minimum Solder Mask Sliver Constraint: (1.874mil < 4mil) Between Pad U11-2(1403.543mil,2681.496mil) on Bottom Layer And Pad U11-3(1403.543mil,2661.811mil) on Bottom Layer [Bottom Solder] Mask Sliver [1.874mil] | 12:49:37 PM | 11/25/2015 | 121
[Minimum Solder Mask Sliver Constraint Violation] | Drude02.PcbDoc | Advanced PCB | Minimum Solder Mask Sliver Constraint: (1.874mil < 4mil) Between Pad U11-1(1403.543mil,2701.181mil) on Bottom Layer And Pad U11-2(1403.543mil,2681.496mil) on Bottom Layer [Bottom Solder] Mask Sliver [1.874mil] | 12:49:37 PM | 11/25/2015 | 122
[Differential Pairs Routing Violation] | Drude02.PcbDoc | Advanced PCB | Differential Pairs Routing: Between Net DSI_CLK_P And Net DSI_CLK_N [Uncoupled Length = 261.312mil], [Maximum Uncoupled Length = 78.74mil] | 12:49:37 PM | 11/25/2015 | 123
[Differential Pairs Routing Violation] | Drude02.PcbDoc | Advanced PCB | Differential Pairs Routing: Between Net LANE0_P And Net LANE0_N [Uncoupled Length = 136.472mil], [Maximum Uncoupled Length = 78.74mil] | 12:49:37 PM | 11/25/2015 | 124
[Differential Pairs Routing Violation] | Drude02.PcbDoc | Advanced PCB | Differential Pairs Routing: Between Net LANE1_P And Net LANE1_N [Uncoupled Length = 207.975mil], [Maximum Uncoupled Length = 78.74mil] | 12:49:37 PM | 11/25/2015 | 125
[Differential Pairs Routing Violation] | Drude02.PcbDoc | Advanced PCB | Differential Pairs Routing: Between Net LANE2_P And Net LANE2_N [Uncoupled Length = 161.432mil], [Maximum Uncoupled Length = 78.74mil] | 12:49:37 PM | 11/25/2015 | 126
[Differential Pairs Routing Violation] | Drude02.PcbDoc | Advanced PCB | Differential Pairs Routing: Between Net LANE3_P And Net LANE3_N [Uncoupled Length = 192.934mil], [Maximum Uncoupled Length = 78.74mil] | 12:49:37 PM | 11/25/2015 | 127

Back to top
