ultimachine/Drude/Drude/ProjectOutputs/Report Board Stack/Drude_0.1a.xls

Board Stack Report
Stack Up |  | Layer Stack
Layer | Board Layer Stack | Name | Material | Thickness | Constant
1 |  | Top Paste
2 |  | Top Overlay
3 |  | Top Solder | Solder Resist | 0.40mil | 3.5
4 |  | Top Layer | Copper | 1.40mil
5 |  | Dielectric 1 | FR-4 TG170 | 3.50mil | 4.6
6 |  | GND | Copper | 1.40mil
7 |  | Dielectric 3 | FR-4 TG170 | 47.25mil | 4.6
8 |  | Supply | Copper | 1.40mil
9 |  | Dielectric 2 | FR-4 TG170 | 3.50mil | 4.6
10 |  | Bottom Layer | Copper | 1.40mil
11 |  | Bottom Solder | Solder Resist | 0.40mil | 3.5
12 |  | Bottom Overlay
13 |  | Bottom Paste
 | Height : 60.65mil
