ultimachine/Drude/Drude/ProjectOutputs/ExportSTEP/Drude_0.1a.step

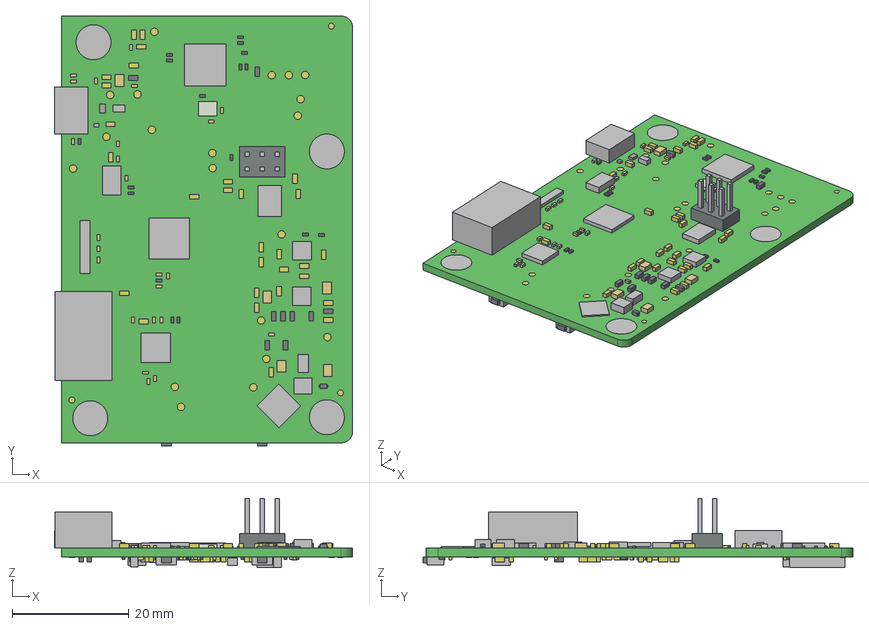
[picture p1: CAD file, 2016-06-02]
Drude/ProjectOutputs/ExportSTEP/Drude_0.1a.step
51.0 x 73.5 x 11.9 mm
Board
Extruded x 190
