ultimachine/Drude/Drude/Signal Integrity Tests Report.txt

Falling Edge Overshoot

The following nets have values outside defined tolerance levels :

Falling Edge Undershoot

The following nets have values outside defined tolerance levels :

Rising Edge Overshoot

The following nets have values outside defined tolerance levels :

Rising Edge Undershoot

The following nets have values outside defined tolerance levels :

Impedance

The following nets have values outside defined tolerance levels :

The following nets were not able to be analysed :

-5.5V
1.2V
1.8OK
1.8V
3.3V
5.5OK
5.5V
5V
AVDD12
AVDD33
BTN_2
GND
I2C_SCL
I2C_SDA
INT
LED-A
LED-K1
LED-K2
LED-PWM
NetC10_1
NetC11_1
NetC12_1
NetC18_1
NetC19_1
NetC20_1
NetC21_1
NetC22_1
NetC23_1
NetC24_2
NetC2_1
NetC32_1
NetC45_1
NetC46_1
NetC49_1
NetC50_1
NetC51_1
NetC55_1
NetC56_1
NetC57_1
NetC58_1
NetC5_1
NetC72_1
NetC77_1
NetC81_2
NetC8_1
NetC91_1
NetD1_A
NetJ5_32
NetR14_1
NetR16_1
NetR24_2
NetR25_2
NetR29_1
NetR2_2
NetR33_1
NetR3_1
NetR5_2
NetR9_1
NetR9_2
PCKIN
PWR_BTN
RESET
RESET_TOUCH
UGND
USBSHIELD
VDDC1
VDDIO1
VDDIO2
VDDMIPI
VDDPLL
VMCU
VUSB
IR
DAOUT
A_WFS
A_SD_3
A_SD_2
A_SD_1
A_SD_0
A_SCK
A_OSCK
UD_P
UR_P
UD_N
UR_N
UC_P
UC_N
NetTP14_TP
NetTP13_TP
NetJ5_28
NetR26_1
NetU4_32
NetU4_29
NetTP12_TP
HDMI_CK_N
HDMI_CK_P
HDMI_D0_N
HDMI_D0_P
HDMI_D1_N
HDMI_D1_P
HDMI_D2_N
HDMI_D2_P
NetJ1_19
NetFL23_2
HDMI_CON_D2_P
HDMI_CON_D2_N
HDMI_CON_D1_P
HDMI_CON_D1_N
HDMI_CON_D0_P
HDMI_CON_D0_N
HDMI_CON_CK_P
HDMI_CON_CK_N
DDC_DAT_CON
DDC_CLK_CON
CEC_CON
NetQ1_6
NetC6_1
NetC6_2
