ultimachine/Drude/Drude/ProjectOutputs/Drude_0.1a_No Variations_VarRevNo.PDF

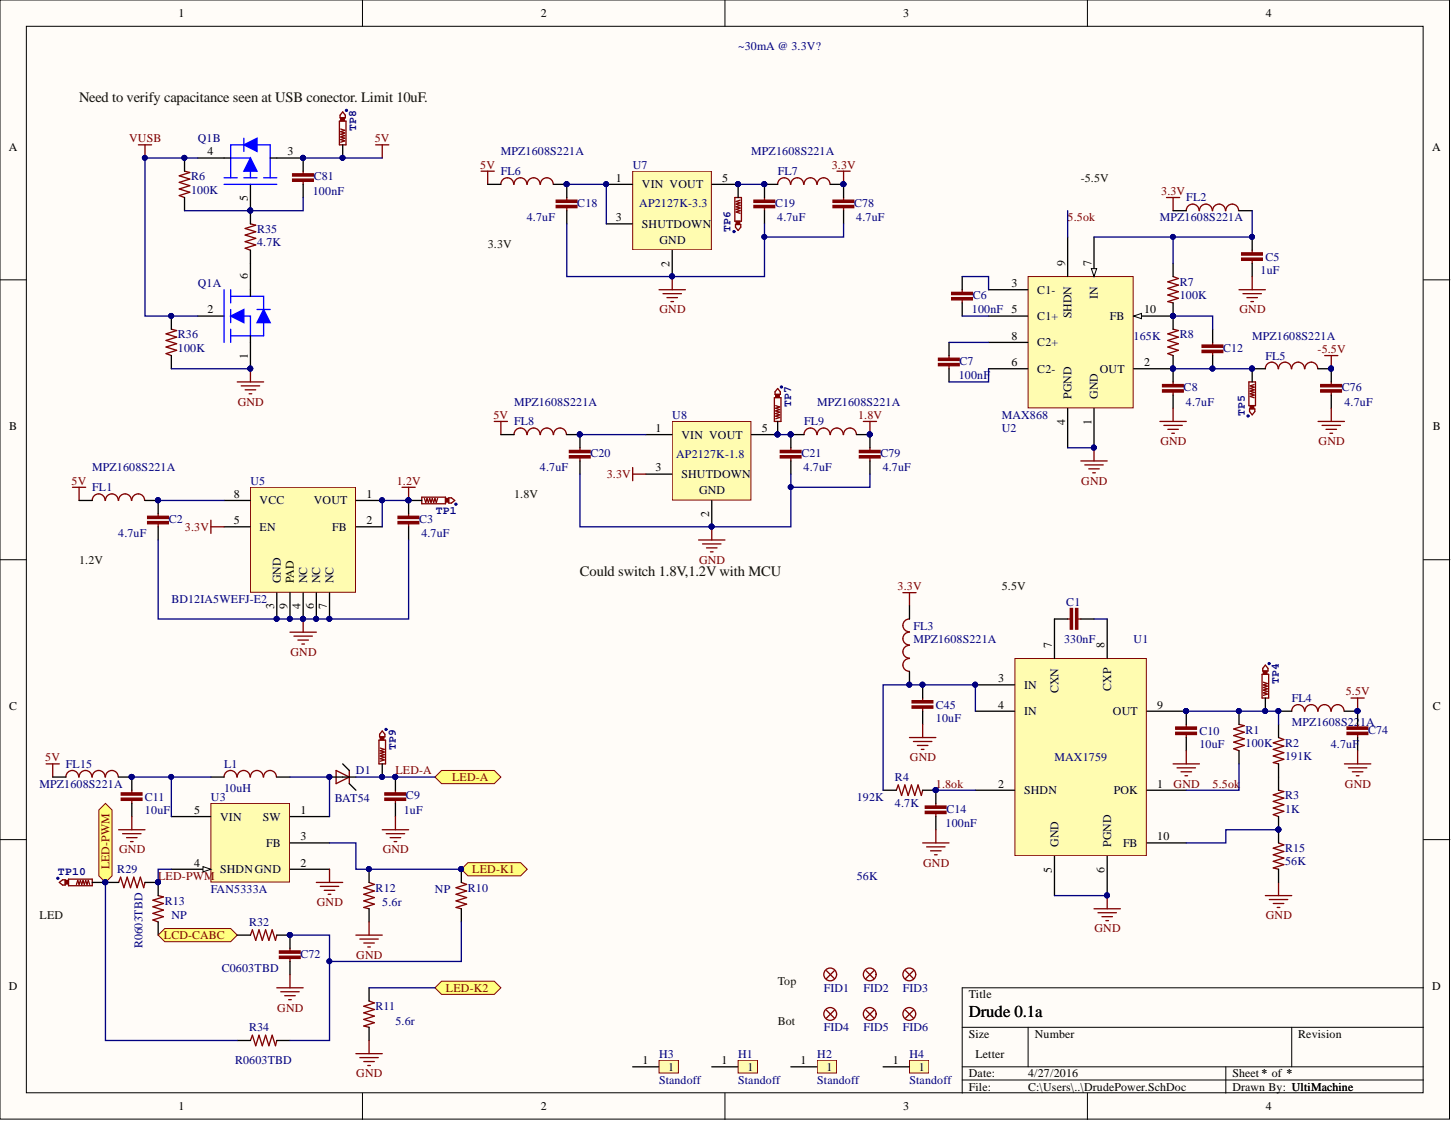
[picture p7: page 1]

Need to verify capacitance seen at USB conector. Limit 10uF.

Could switch 1.8V,1.2V with MCU

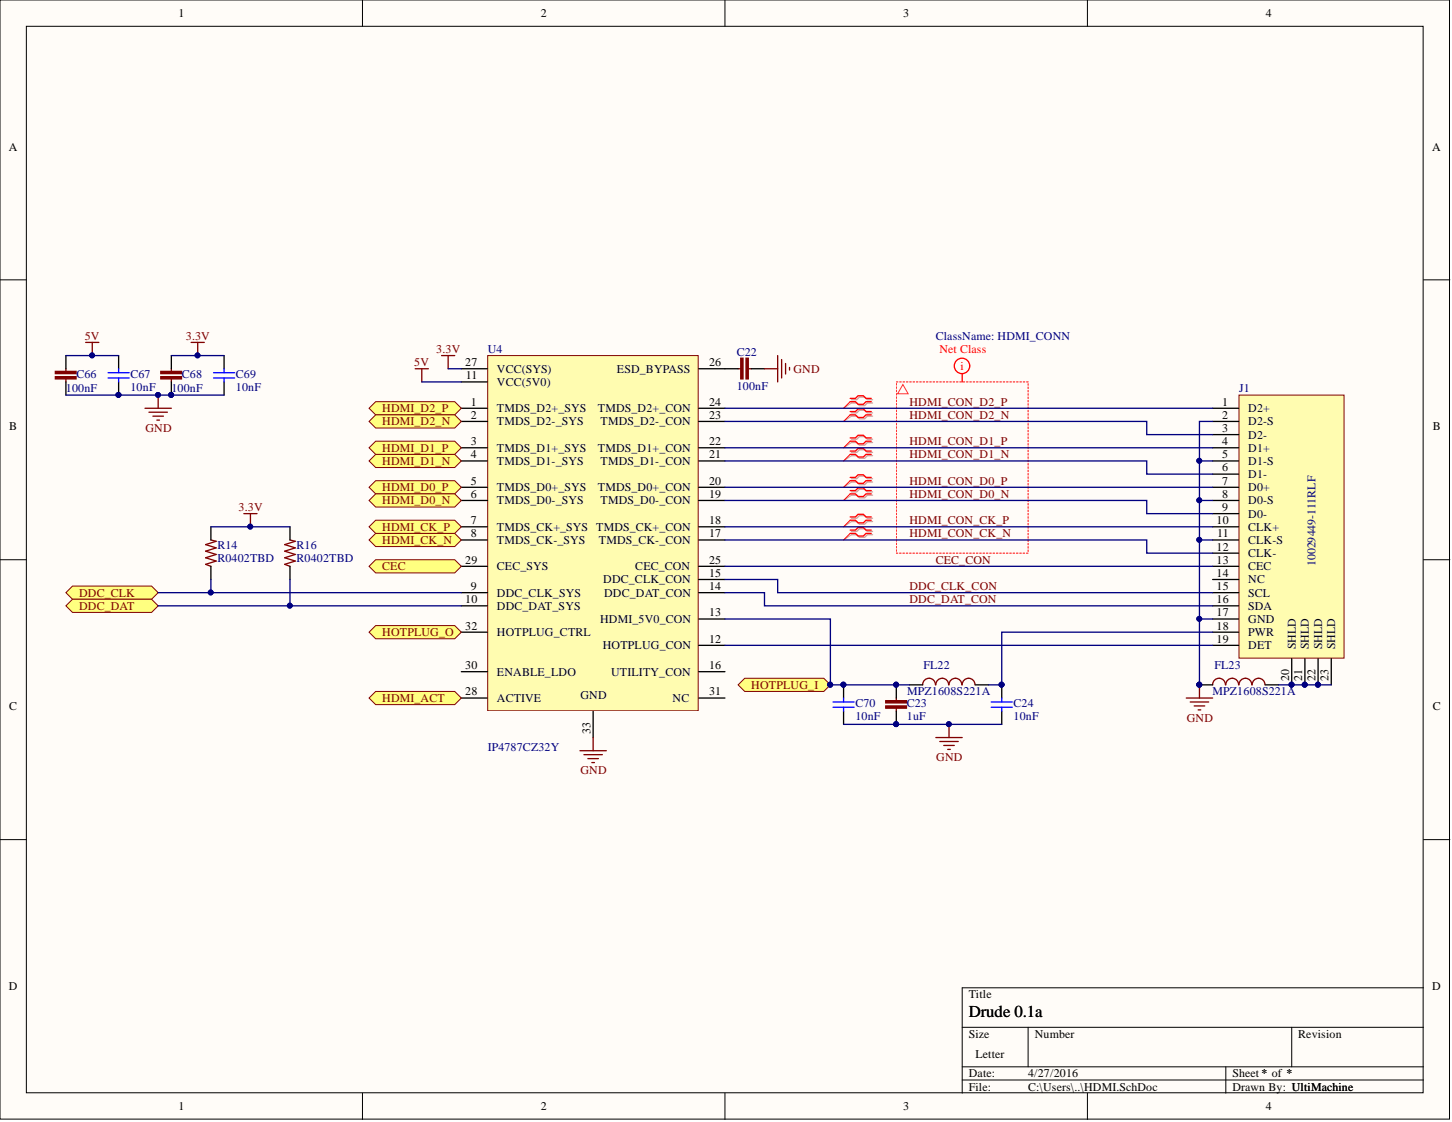
[picture p8: page 2]

2 3 | H DMI_CO N _ D 2 _ N | 2
2 2 | | | | 3

H DMI_CO N _ D 1 _ P | 4

2 1 | | H DMI_CO N _ D 1 _ N | 5
2 0 | | | | 6

H DMI_CO N _ D 0 _ P | 7

1 9 | | H DMI_CO N _ D 0 _ N | 8
1 8 | | | | 9

H DMI_CO N _CK _ P | 1 0

1 7 | | H DMI_CO N _CK _ N | 1 1
2 5 | | | | 1 2

1 5 | 1 4
1 4 | D DC_CL K _CO N | | 1 5

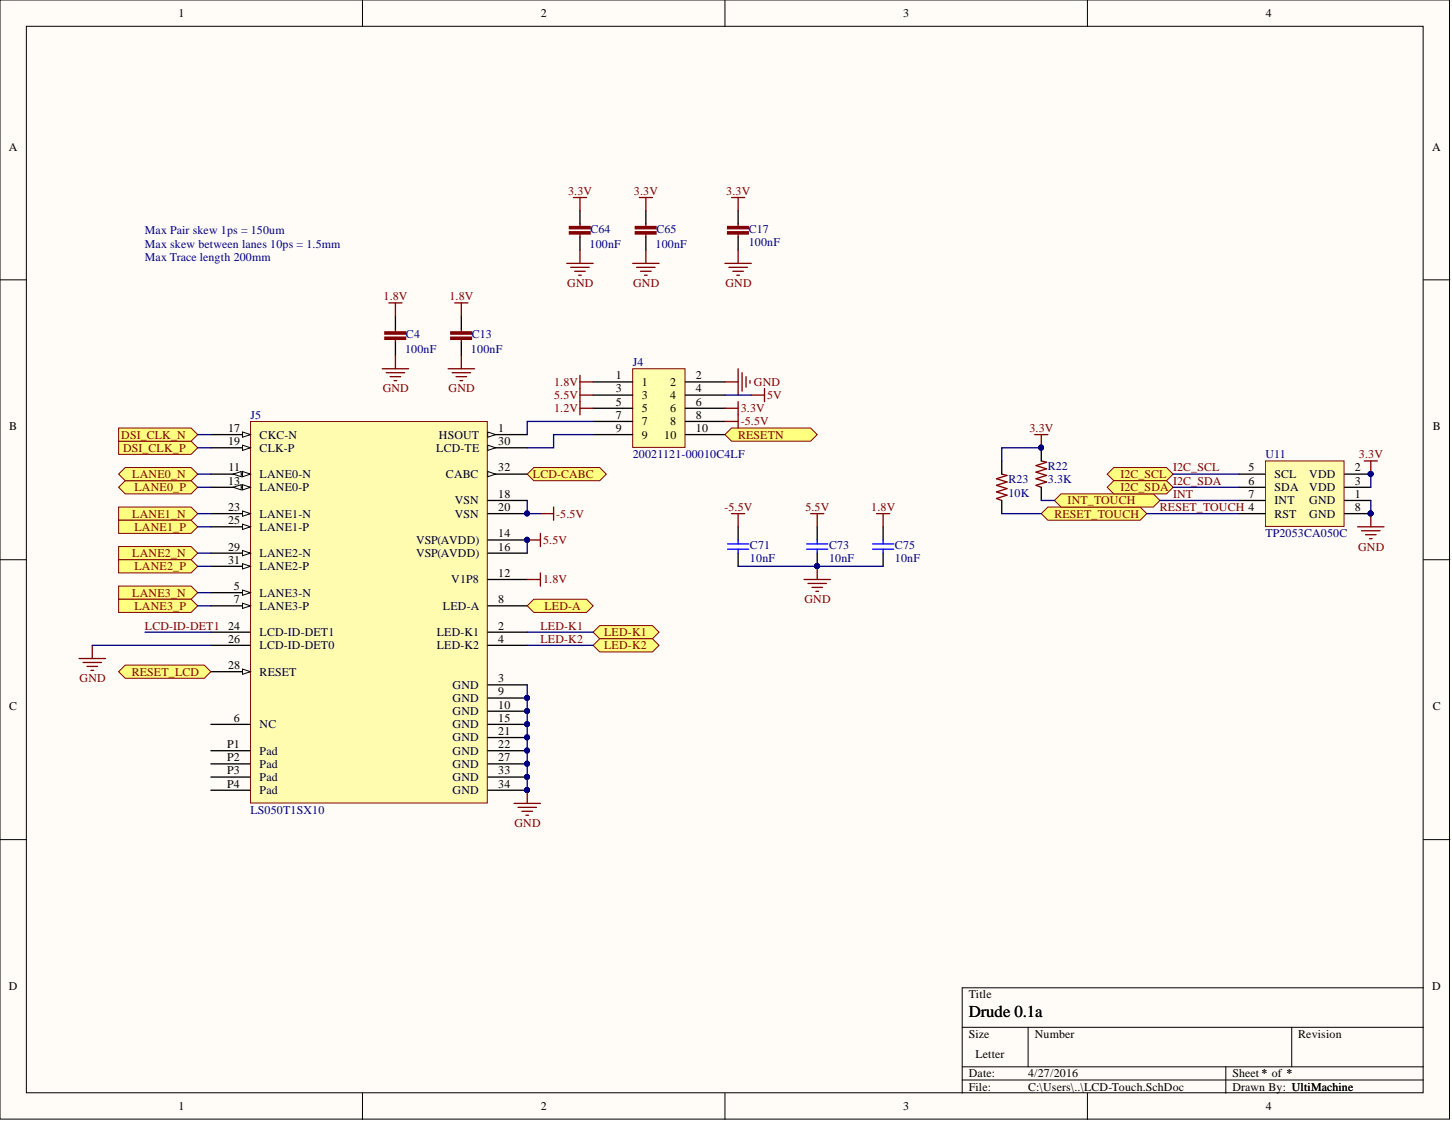
[picture p9: page 3]

Max Pair skew 1ps = 150um
Max skew between lanes 10ps = 1.5mm
Max Trace length 200mm

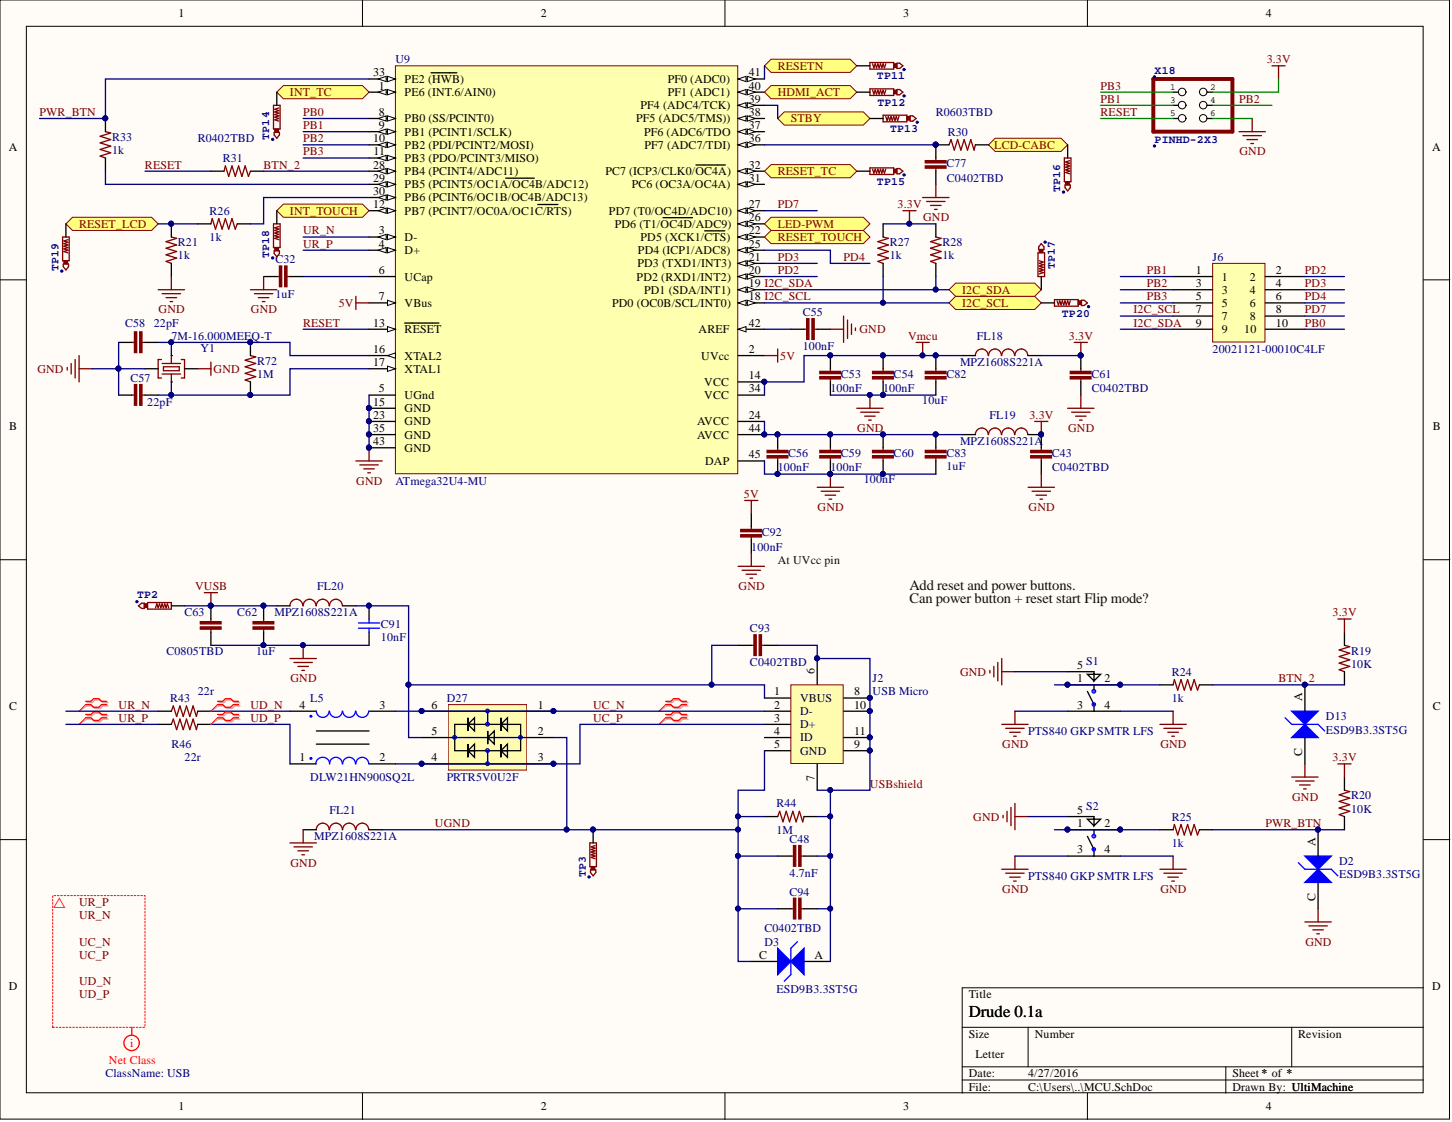
[picture p10: page 4]

XTAL1 17

UGnd 5

Add reset and power buttons. Can power button + reset start Flip mode?

6 D27 | D- 2 | 10
5 | UC_P | D+ 3 | 11

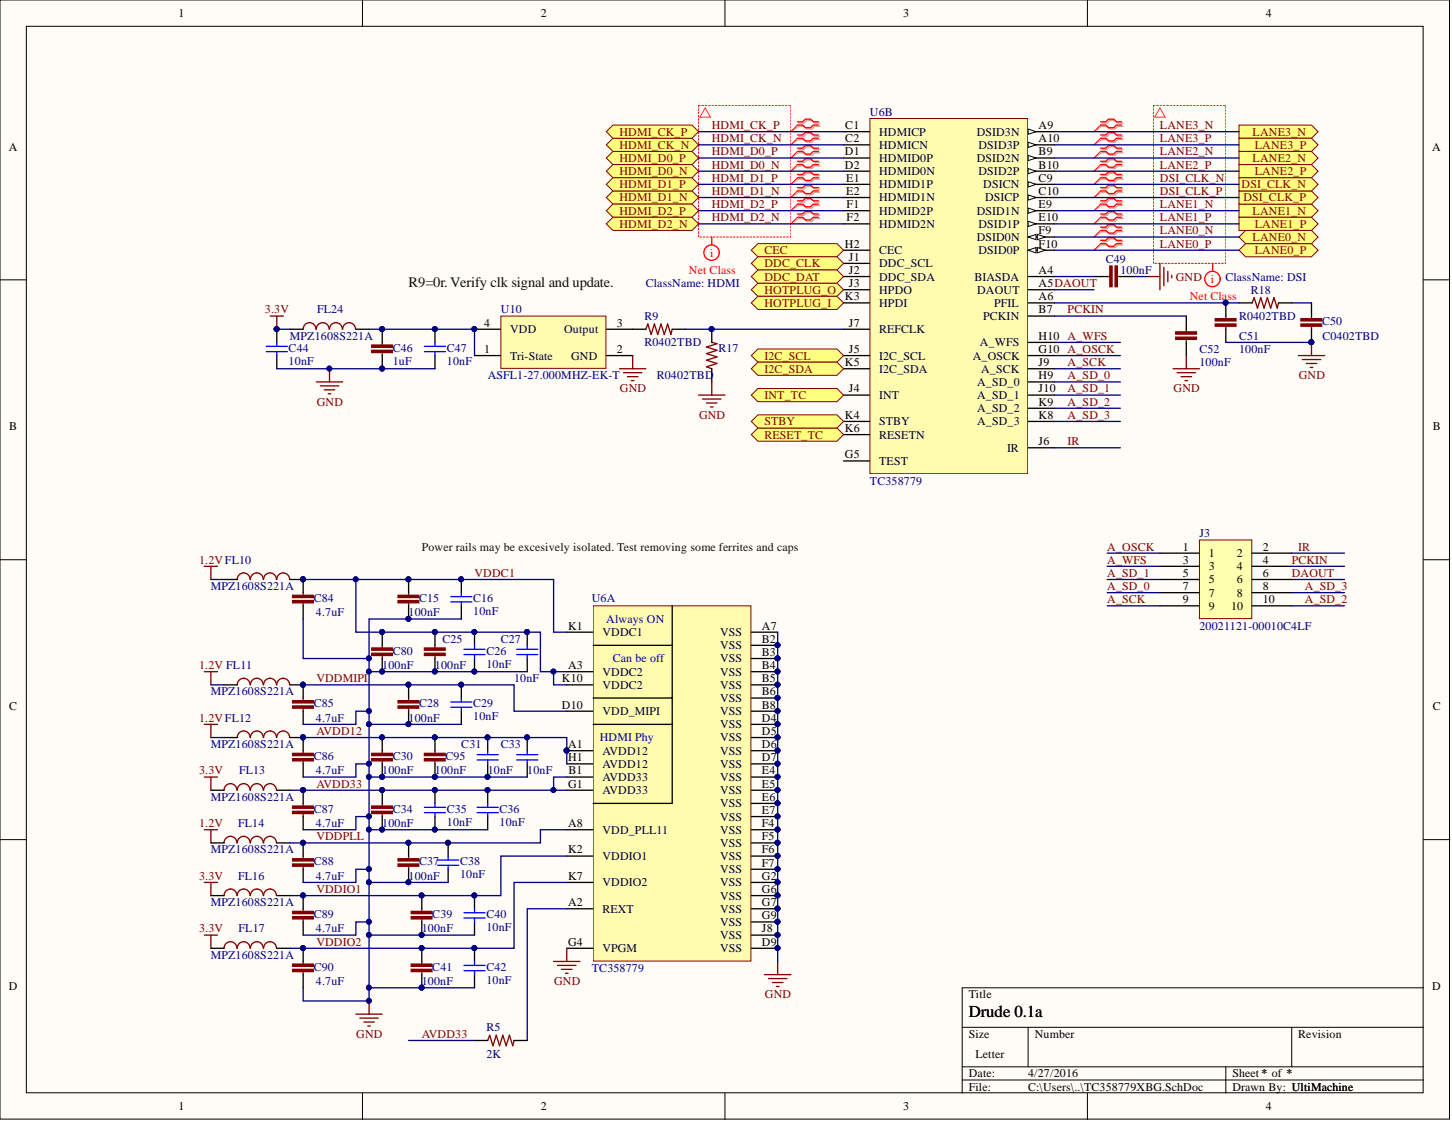
[picture p11: page 5]

H DMI_CK _ N
H DMI_ D 0 _ P
H DMI_ D 0 _ N
H DMI_ D 1 _ P
H DMI_ D 1 _ N
H DMI_ D 2 _ P
H DMI_ D 2 _ N

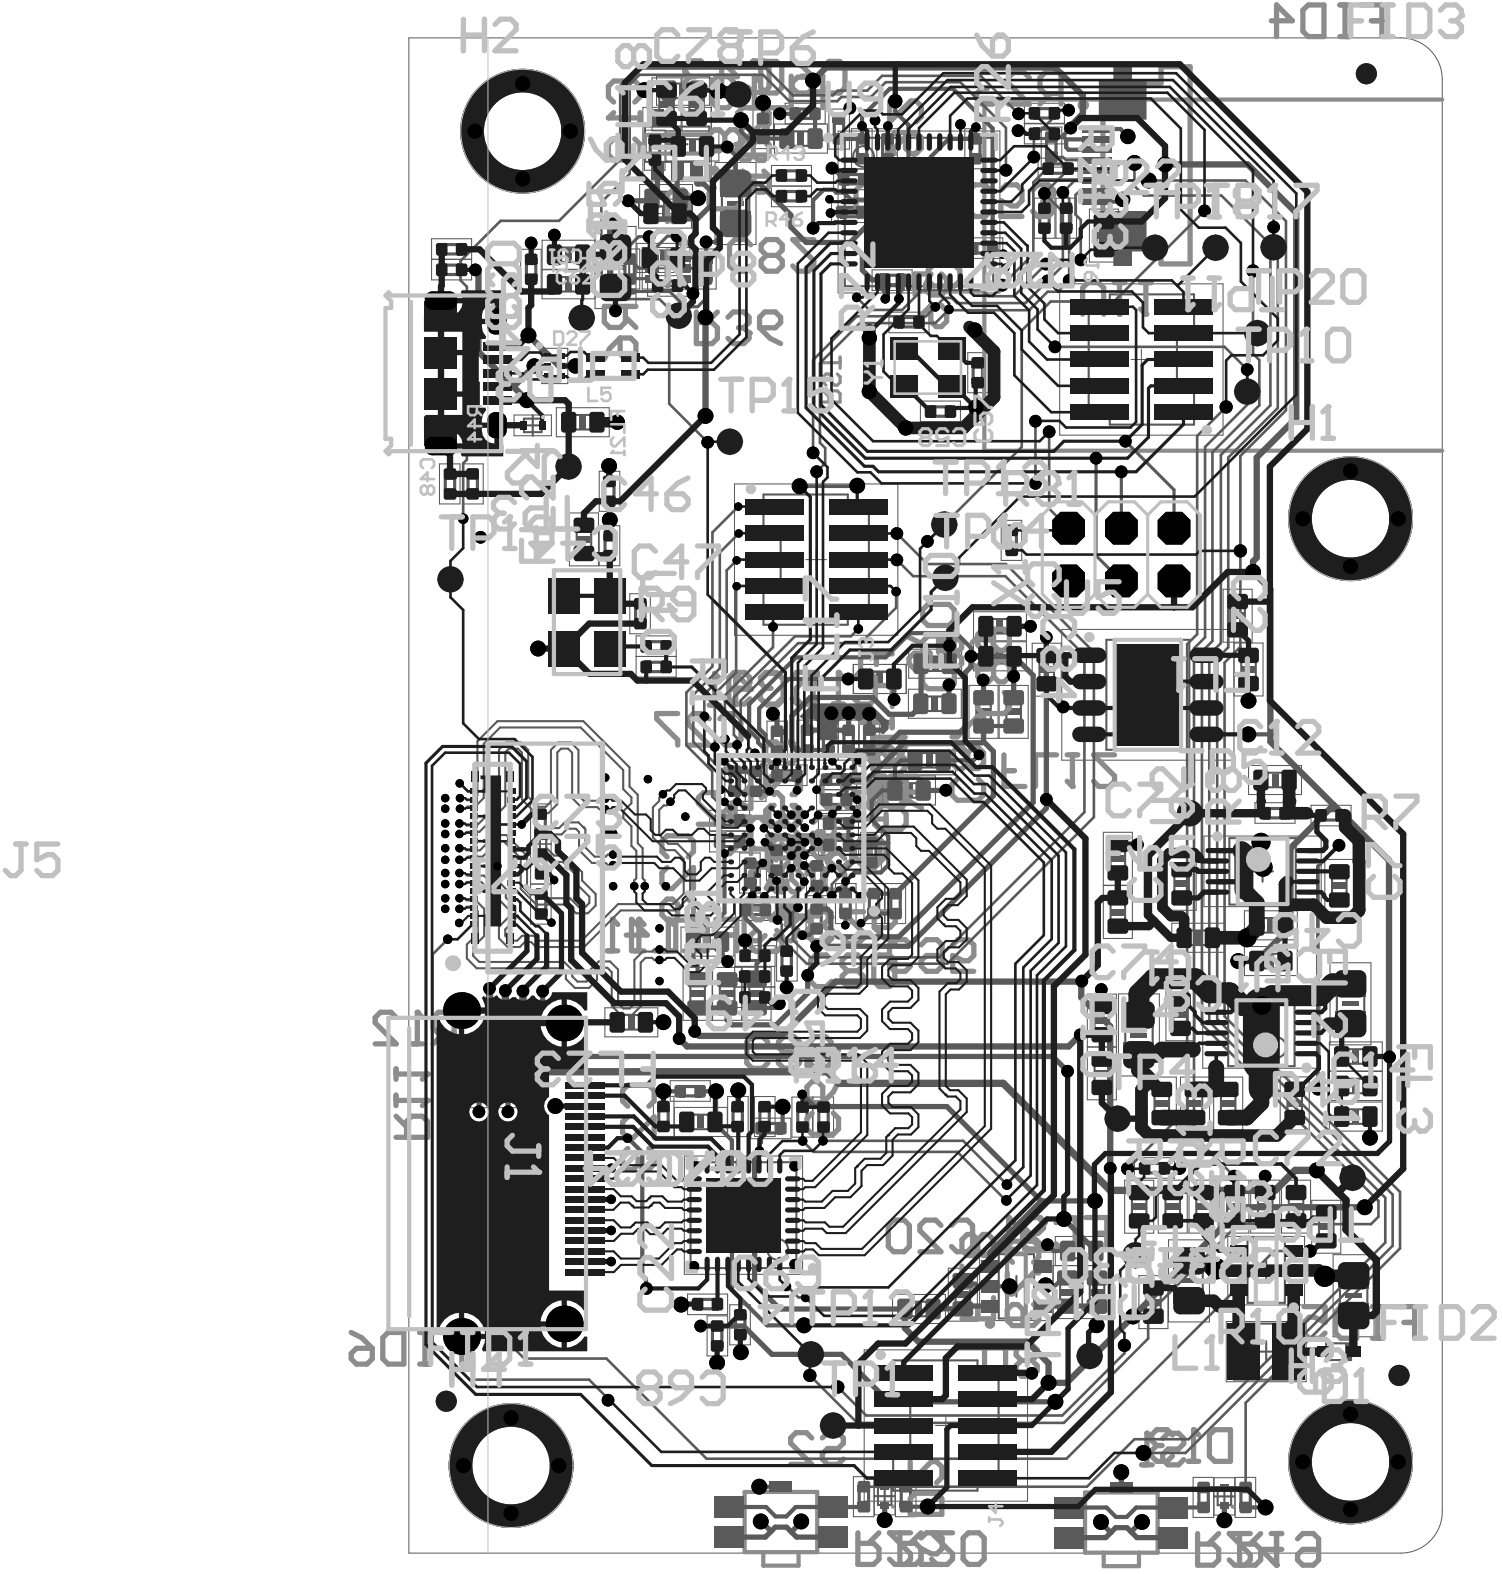
[picture p12: page 6]

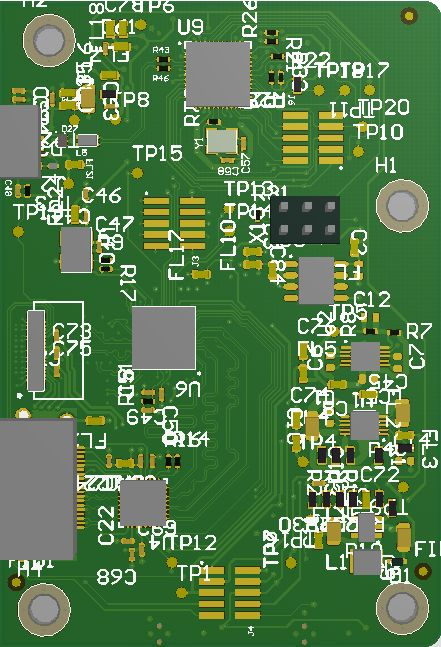
[picture p13: figure]
