ultimachine/Drude/(list of files, drawings)

Other design files:
Drude/Drude02.PcbDoc
Drude/Drude.PcbDoc
Drude/Drude.PrjPcb
Drude/DrudePower.SchDoc
Drude/HDMI.SchDoc
Drude/LCD-Touch.SchDoc
Drude/MCU.SchDoc
Drude/TC358779XBG.SchDoc
DrudePower.SchDoc
Panels/Drude-panel.PcbDoc
Panels/Drude-panel.PrjPcb
PCC-0019-00096-2/Released/44PW_L-UM.PcbLib
PCC-0019-00096-2/Released/44PW_L.PcbLib
SYM-0019-00108-1/Released/MC-8B-ATM16U4-SQ45.SchLib
