ultimachine/Drude/(commit log)

2015-11-26 diff trace rule work
    [Drude.PrjPcb, Drude02.PcbDoc, DrudePower.SchDoc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]
2016-02-14 rotating connectors to under display
    [Drude02.PcbDoc, DrudePower.SchDoc, LCD-Touch.SchDoc, MCU.SchDoc]
2016-03-01 add filtering on power rails in schematic
    [Drude02.PcbDoc, DrudeCalcs.ods, DrudePower.SchDoc, HDMI.SchDoc, LCD-Touch.SchDoc, MCU.SchDoc, TC358779XBG.SchDoc]
2016-03-01 4.7uF caps to 0603
    [DrudePower.SchDoc, HDMI.SchDoc, TC358779XBG.SchDoc]
2016-03-09 placing power filters,etc
    [Drude.PrjPcb, Drude02.PcbDoc, DrudeCalcs.ods, DrudePower.SchDoc, MCU.SchDoc, TC358779XBG.SchDoc]
2016-03-15 most airwires routed. Reworking dsi
    [Drude02.PcbDoc, HDMI.SchDoc, LCD-Touch.SchDoc, MCU.SchDoc, TC358779XBG.SchDoc]
2016-03-18 Minor layout tweaks
    [Drude02.PcbDoc]
2016-04-21 dsi work
    [Drude02.PcbDoc, DrudeCalcs.ods]
2016-04-21 dsi work2
    [Drude02.PcbDoc]
2016-05-04 diff trace reworks
    [Drude.PrjPcb, Drude02.CSV, Drude02.PcbDoc, DrudeCalcs.ods, DrudePower.SchDoc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]
2016-05-05 power rail / mounting hole cleanup
    [Drude-panel.PcbDoc, Drude-panel.PrjPcb, Drude.PrjPcb, Drude02.PcbDoc, DrudeCalcs.ods, DrudePower.SchDoc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]
2016-05-09 miscelaneous cleanups. reword impedance spec.
    [Drude-panel.PcbDoc, Drude-panel.PrjPcb, Drude02.PcbDoc, DrudeCalcs.ods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]
2016-06-01 0.1 files to fab
    [Drude02.CSV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]
2016-06-01 fix paste pip connectors, part name
    [Drude.PrjPcb, Drude02.PcbDoc, LCD-Touch.SchDoc]
2016-06-02 regen gerbers untested
    [Drude_0.1a.GBL, Drude_0.1a.GBO, Drude_0.1a.GBP, Drude_0.1a.GBS, Drude_0.1a.GM1, Drude_0.1a.GTL, Drude_0.1a.GTO, Drude_0.1a.GTP]
